tomasz-jankowski/arduino-game-platform/images/pcb-schema.png

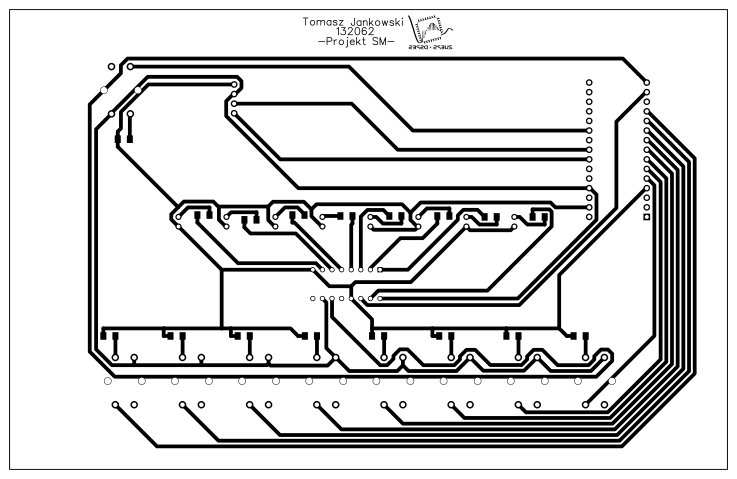
images/pcb-schema.png
