tomasz-jankowski/arduino-game-platform/images/pcb-visualization.png

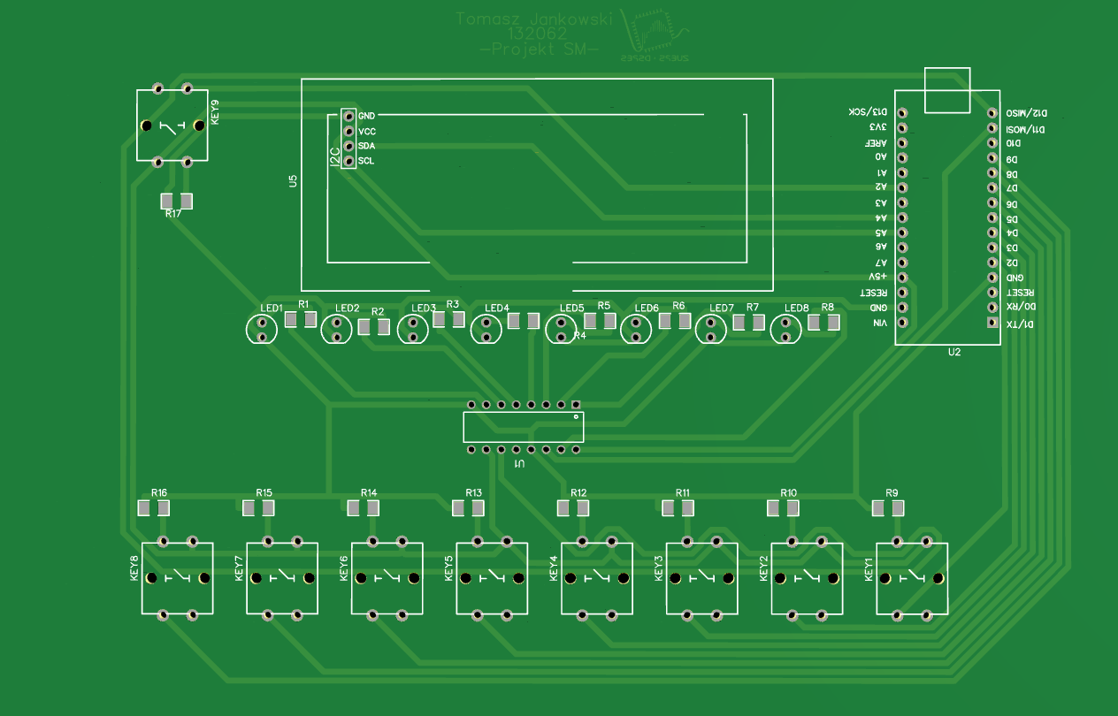
images/pcb-visualization.png
